willow-carroll-polzin/EDUSAT/Hardware/edusat_protoV1_nolabels.png

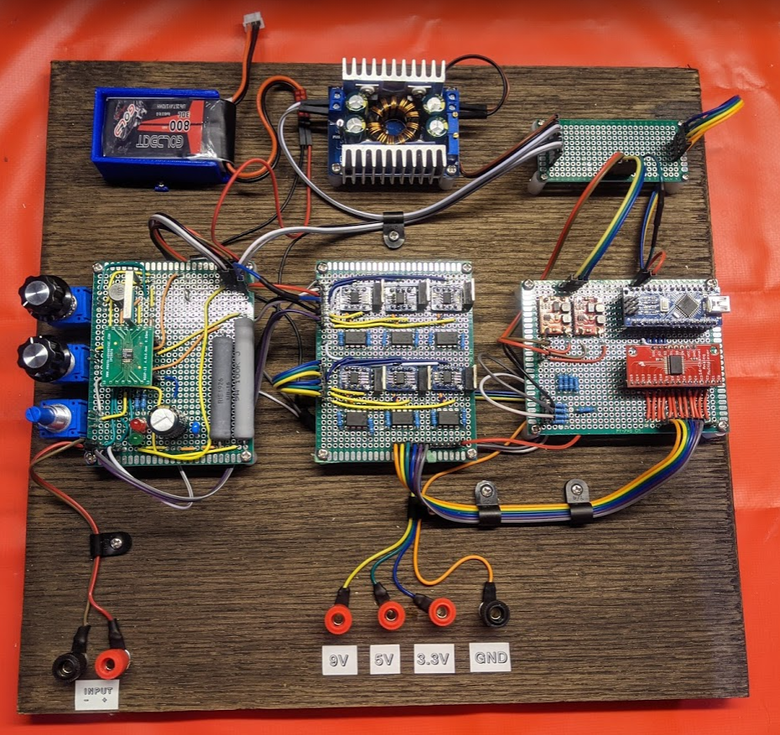
Hardware/edusat_protoV1_nolabels.png
