willow-carroll-polzin/EDUSAT/Hardware/edusat_protoV1.png

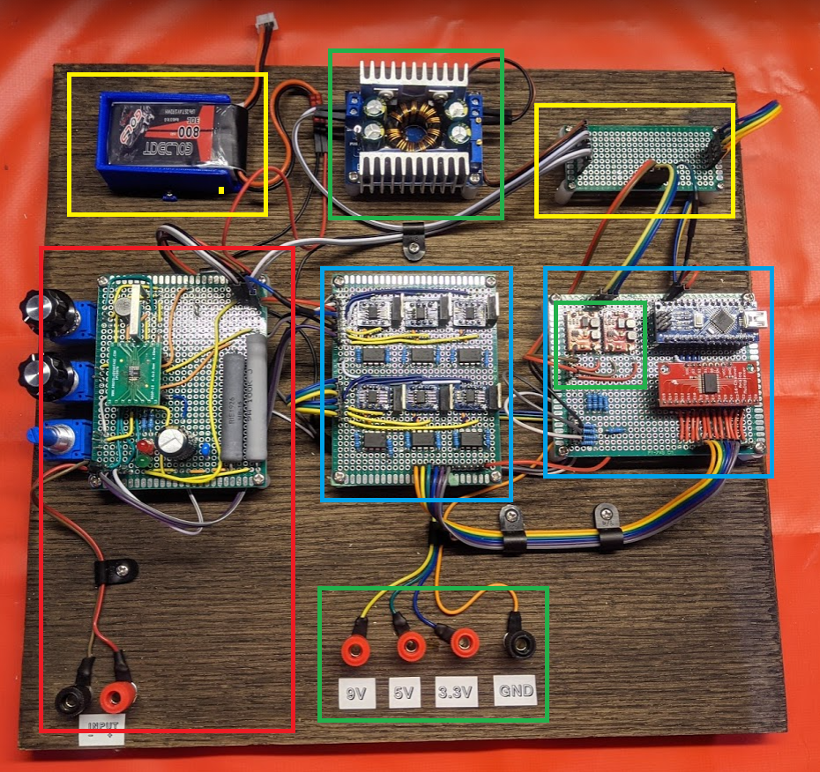
Hardware/edusat_protoV1.png
