willow-carroll-polzin/EDUSAT/EDUSAT_App/webpage/src/teleconference.jpg

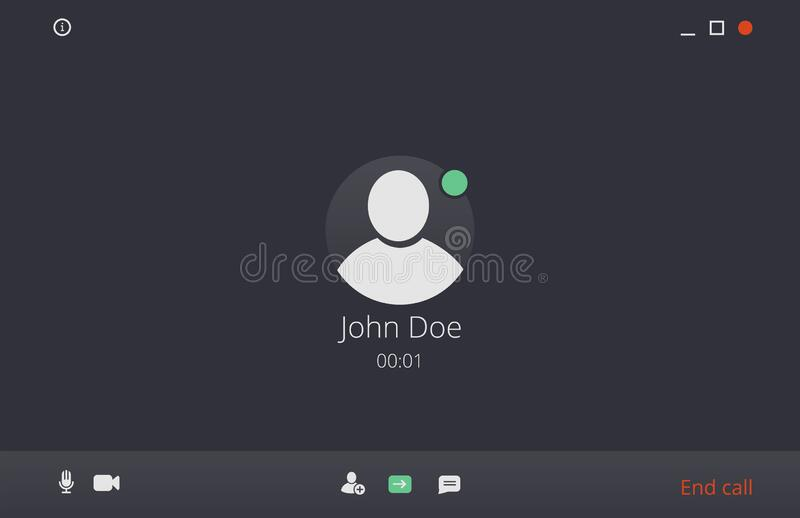
EDUSAT_App/webpage/src/teleconference.jpg
