willow-carroll-polzin/EDUSAT/Hardware/edusat_blockdiagram.png

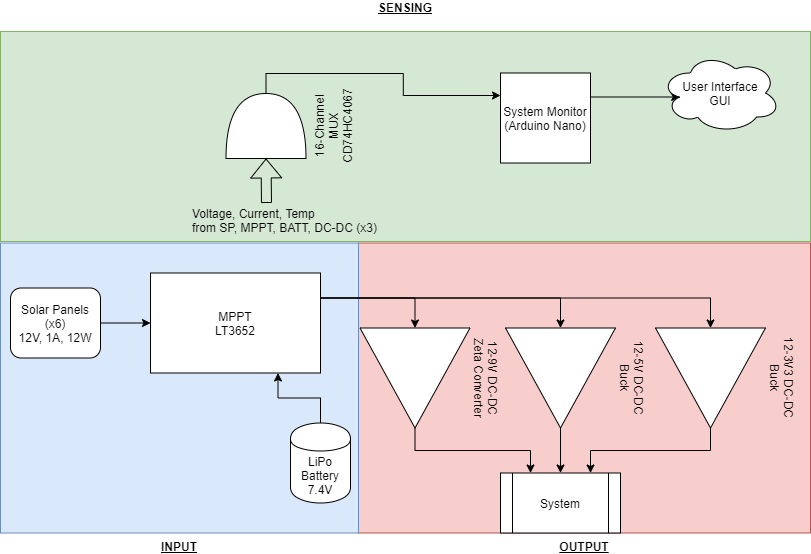
Hardware/edusat_blockdiagram.png
