willow-carroll-polzin/EDUSAT/Hardware/edusat_dcdc.png

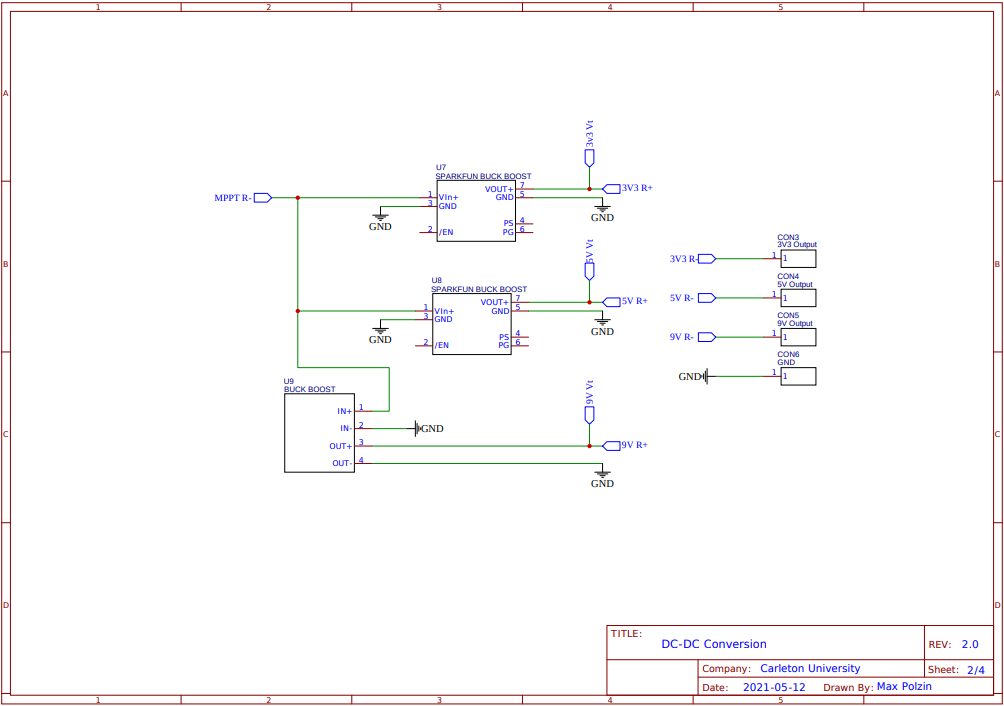
Hardware/edusat_dcdc.png
