willow-carroll-polzin/EDUSAT/Hardware/edusat_mppt.png

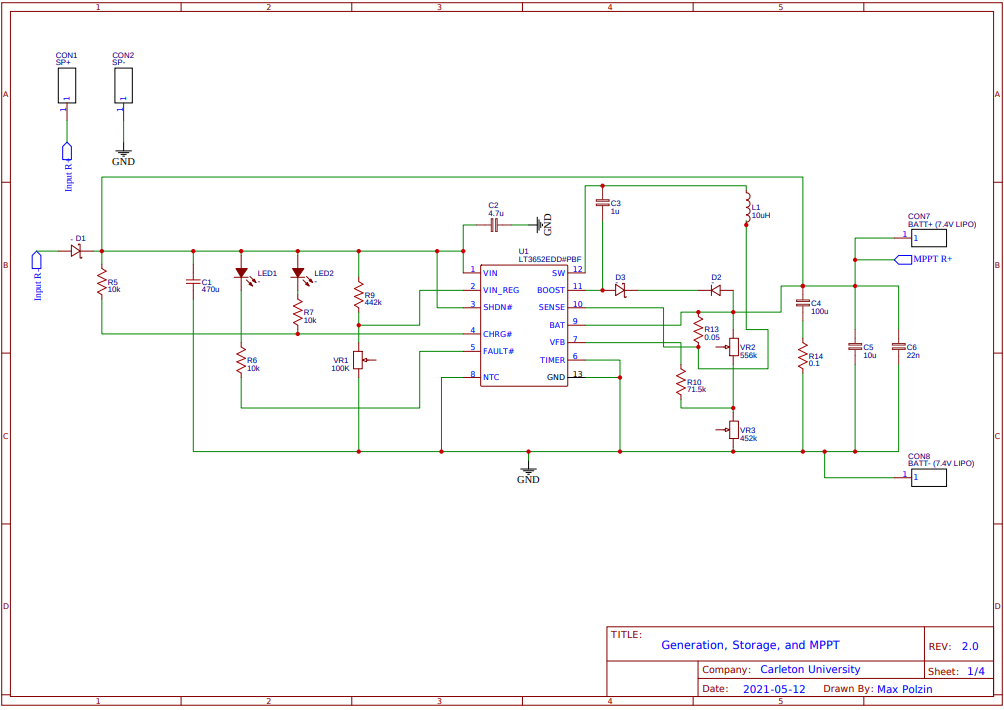
Hardware/edusat_mppt.png
