willow-carroll-polzin/EDUSAT/Hardware/edusat_sense.png

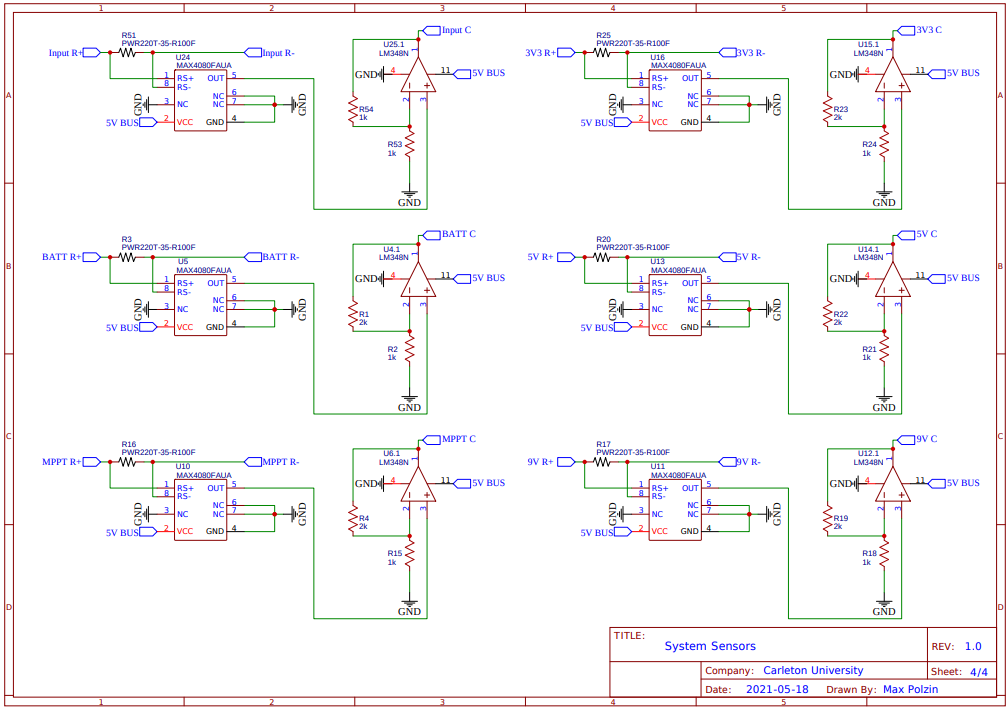
Hardware/edusat_sense.png
