willow-carroll-polzin/EDUSAT/Hardware/edusat_sensors.png

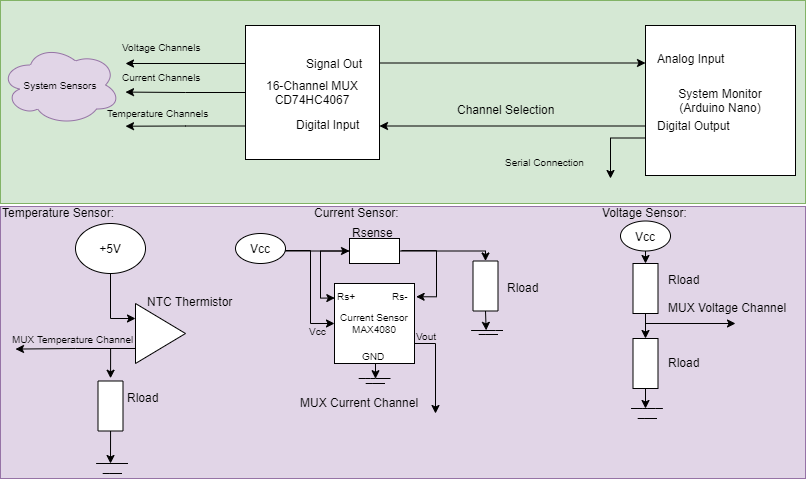
Hardware/edusat_sensors.png
