willow-carroll-polzin/EDUSAT/Hardware/edusat_telem.png

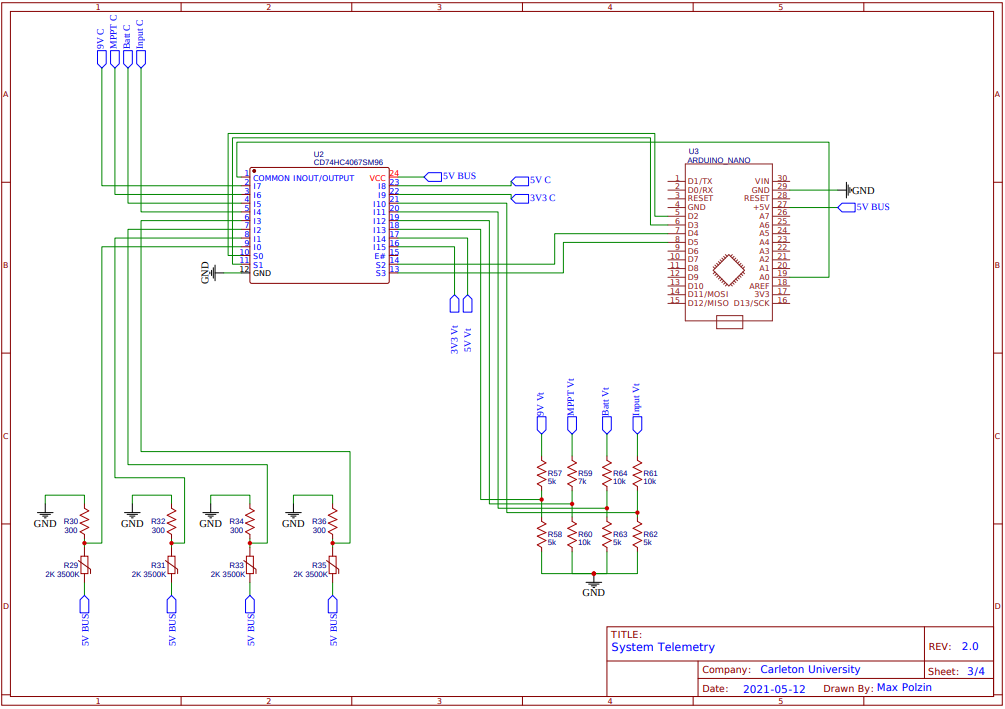
Hardware/edusat_telem.png
