willow-carroll-polzin/EDUSAT/EDUSAT_Telem/EDUSAT_Telem/MUX.cpp

// ====================
// Libraries
// ====================
#include "MUX.h"

// =================
// Multiplex Class
// =================
MultiPlex::MultiPlex(){
    muxSize = 16;
    controlPins[0] = 2;
    controlPins[1] = 3;
    controlPins[2] = 4;
    controlPins[3] = 5;
    sigPin = A1;
    //*muxChannels = &binaryChannels;
}

MultiPlex::MultiPlex(int size, int sig1, int sig2, int sig3, int sig4, int data)
{
    muxSize = size;
    controlPins[0] = sig1;
    controlPins[1] = sig2;
    controlPins[2] = sig3;
    controlPins[3] = sig4;
    sigPin = data;
    //*muxChannels = &binaryChannels;
}

float MultiPlex::readMux(int channel)
{
    //Loop through all 4 digital "signal" pins to set the mux Channel (channel=1<->16)
    for (int j = 0; j < 4; j++)
    {
        digitalWrite(controlPins[j], muxChannels[channel][j]);
    }

    //Read current MUX output on the selected channel from the data/signal pin
    float val = analogRead(sigPin) * (5.0 / 1023.0);
    return val;
}
