willow-carroll-polzin/EDUSAT/(commit log)

2020-05-13 Add files via upload
    Current test scripts for system telemetry,
2020-07-12 Fixing issues with telem prints
    [EDUSAT_Telem.ino]
2020-07-12 Fixed telem output, now output sensor data in the correct fashion
    [EDUSAT_Telem.ino]
2020-07-26 Switched GUI from PyQT5 to tkinter
2020-08-26 Updated socket emits on server
2020-08-26 Changed the data request and sending structure from the serial reader to the server and then to the webpage client on socketio
2020-09-19 Created a method to write current telem data to a csv
2020-09-27 Broke up the ino so that each part is now in a class format in .cpp's and .h's, should be easier to edit and read now
    [EDUSAT_Telem.ino, Sensors.cpp, Sensors.h, SystemStatus.cpp, SystemStatus.h]
2020-09-27 Fixed some of the bugs, still not compiling correctly, have issue with pointer to the muxChannels array
    [EDUSAT_Telem.ino, Sensors.cpp, Sensors.h, SystemStatus.cpp, SystemStatus.h]
2020-10-21 Fixed some of the compiler issues, a few more to go, had to change the sensor class a little
    [Sensors.cpp, Sensors.h, SystemStatus.cpp, SystemStatus.h]
2020-10-21 Fixed the compiler erros except for the mux read problem.
    [EDUSAT_Telem.ino, Sensors.cpp, SystemStatus.cpp]
2020-10-24 Fixed issue with hanging on SystemStatus creation, was due to extra Serial.begins randomly in non .ino files
    [EDUSAT_Telem.ino, SystemStatus.cpp]
2020-10-24 fixed telem so now it prints in the epexted way, just need to test it on the two circuits
    [test.csv]
2020-10-27 Fixed a bunch of problems; memory overflow in update status due recreating v,i,t counters every time (which also werent being reset), there was also some minor issues in the mux code and how it selec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
    [EDUSAT_Telem.ino, MUX.cpp, MUX.h, Sensors.cpp, Sensors.h, SystemStatus.cpp, SystemStatus.h]
2020-11-19 Updated mux and sensors pins to reflect hardware design changes
2020-12-02 Fixed the voltage and current calculations
    [Sensors.cpp, Sensors.h, SystemStatus.cpp]
2021-05-10 Bump socket.io from 2.3.0 to 2.4.0 in /EDUSAT_App/socket_server
    Bumps [socket.io](https://github.com/socketio/socket.io) from 2.3.0 to 2.4.0.
    - [Release notes](https://github.com/socketio/socket.io/releases)
    - [Changelog](https://github.com/socketio/socket.io/blob/2.4.0/CHANGELOG.md)
    - [Commits](https://github.com/socketio/socket.io/compare/2.3.0...2.4.0)
2021-05-10 Updates to README, also removed old files and folders
    [test.csv]
2021-05-10 Added Hardware schematics folder
2021-05-12 Outlined section for explanation of sensor types
2021-05-14 Updates to the prototype explanation and image.
2021-05-14 Started explanation for sensor measurments
2021-05-19 Updated hardware CAD
2021-06-26 Update index.tsx
    Fixed voltage graph legend to show "Voltage #1" ... etc instead of "Temperature #1"
2021-06-26 Updated telem file structure so it can be easily flashed. Added newest CAD to Hardware folder
2021-07-21 Update README.md
    Added temperature formulas
2021-07-22 Update README.md
    added table to voltage measurements
2021-07-22 Update README.md
    Formulas for sensors completed
2021-07-22 Update README.md
    update script description and bom
2021-07-22 Update README.md
    updates to mini bom
2021-07-22 Update README.md
    updated mini bom
2021-07-22 Create README.md
    added statement under BOM section
2021-07-22 Fixed weird file structure
    [EDUSAT_Telem.ino, MUX.cpp, MUX.h, Sensors.cpp, Sensors.h, SystemStatus.cpp, SystemStatus.h]
